KomodoOpenLab/TeclaShield/case/laser-cut/case.dxf

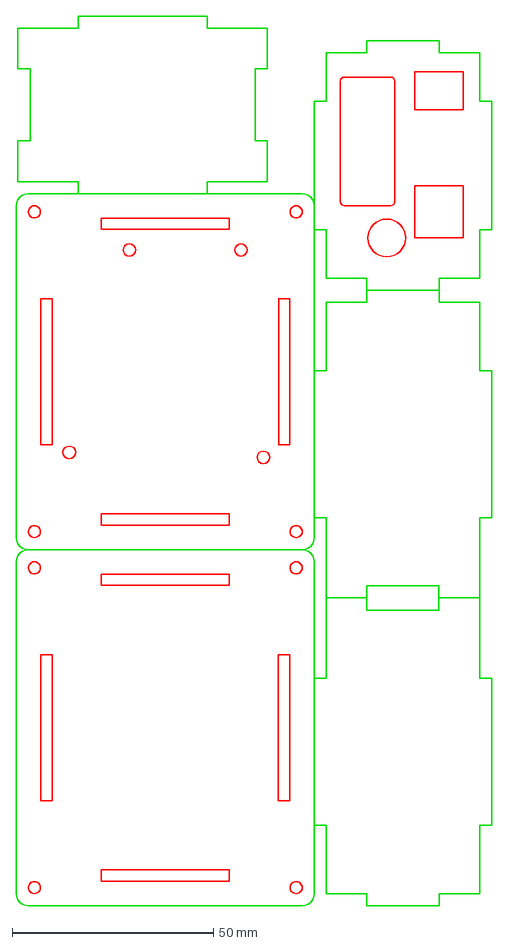
[picture p1: CAD file, 2011-03-05]
case/laser-cut/case.dxf
118.2 x 221.1 mm
